jonsowman/GutterNode/enclosure/gutside.stl

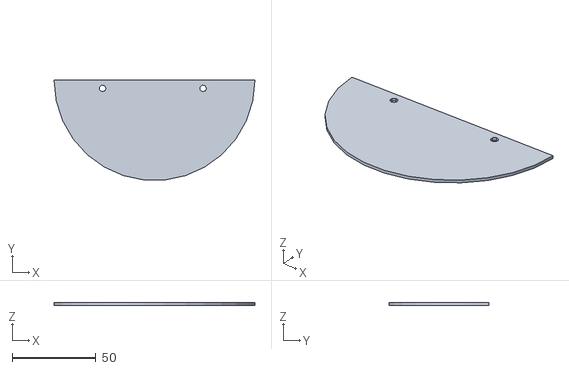
[picture p1: CAD file, 2015-03-28]
enclosure/gutside.stl
120.0 x 59.7 x 1.50
