jonsowman/GutterNode/enclosure/gnode21.stl

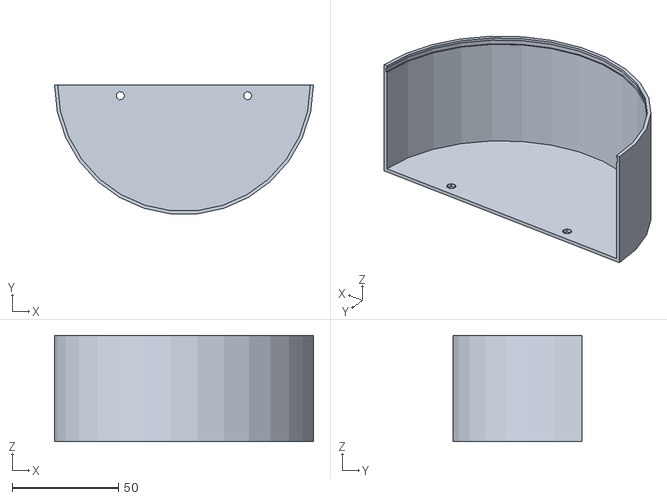
[picture p2: CAD file, 2015-03-26]
enclosure/gnode21.stl
122.0 x 60.7 x 50.0
