jonsowman/GutterNode/enclosure/guttop.stl

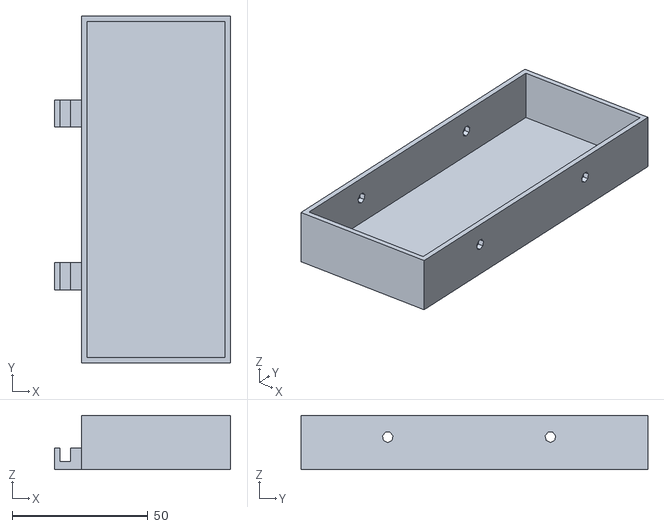
[picture p3: CAD file, 2015-03-25]
enclosure/guttop.stl
65.0 x 128.0 x 20.0
