jonsowman/GutterNode/hardware/cn3083-breakout/breakout.brd

## EAGLE design hardware/cn3083-breakout/breakout.brd (2015-04-07)

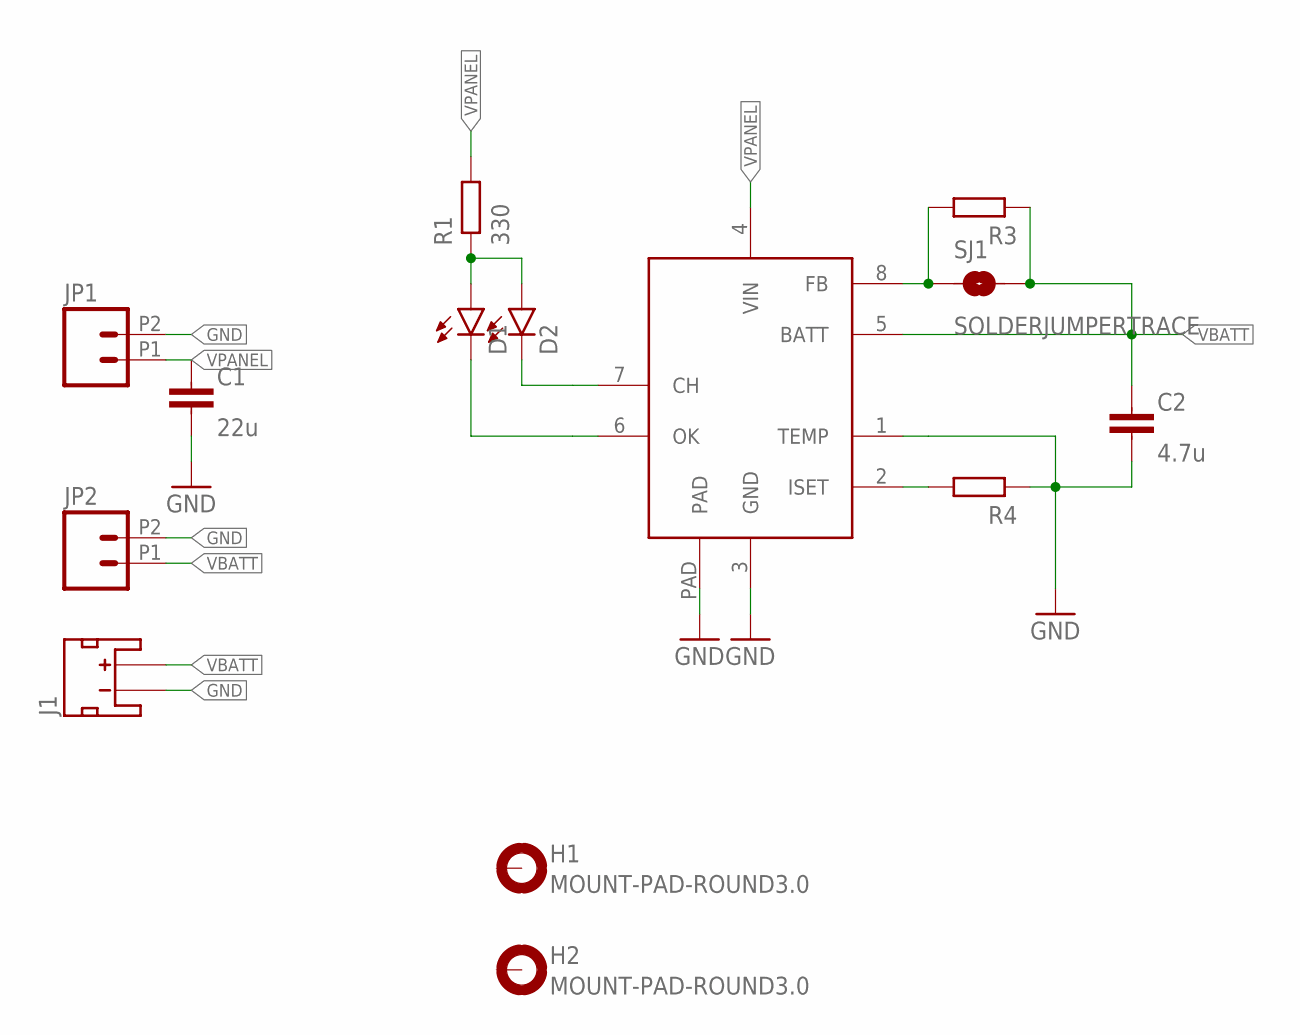
[picture p4: schematic breakout.sch]

Parts:
C1: 22u; C0603-N
C2: 4.7u; C0603-N
D1, D2: LED0603; LED-0603
H1, H2: MOUNT-PAD-ROUND3.0; 3,0-PAD
J1: JST_2MM_MALE_TH; JST-2-TH
JP1, JP2: M022.54MM_SCREWTERM; 1X02_2.54_SCREWTERM
R1: 330; R0603-N
R3, R4: RESISTOR0603-N; R0603-N
SJ1: SOLDERJUMPERTRACE; SJ_2S-TRACE
U1: CN3083; SO8-PAD

Connections:
GND: C1.2, C2.2, J1.2 (-), JP1.P2 (2), JP2.P2 (2), R4.1, U1.1 (TEMP), U1.3 (GND), U1.PAD
unnamed: D1.A, D2.A, R1.1
unnamed: R4.2, U1.2 (ISET)
unnamed: D2.C, U1.7 (CH)
unnamed: D1.C, U1.6 (OK)
unnamed: R3.2, SJ1.1, U1.8 (FB)
VBATT: C2.1, J1.1 (+), JP2.P1 (1), R3.1, SJ1.2, U1.5 (BATT)
VPANEL: C1.1, JP1.P1 (1), R1.2, U1.4 (VIN)

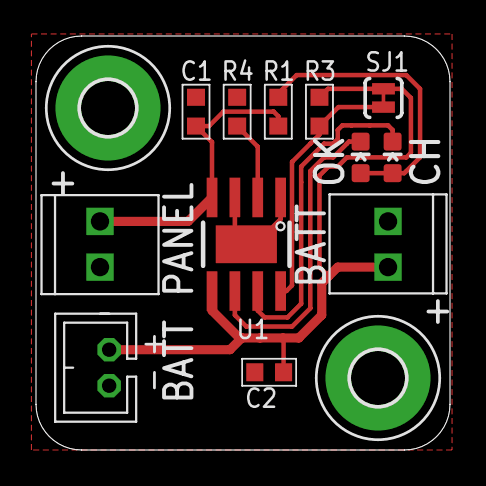
[picture p5: board breakout.brd from above]

Board: 2 copper layers, 23.0 x 23.0 mm, 14 parts (0 on the bottom side), 8 nets.
