jonsowman/GutterNode/hardware/gnode/gnode.brd

## EAGLE design hardware/gnode/gnode.brd (2015-04-05)

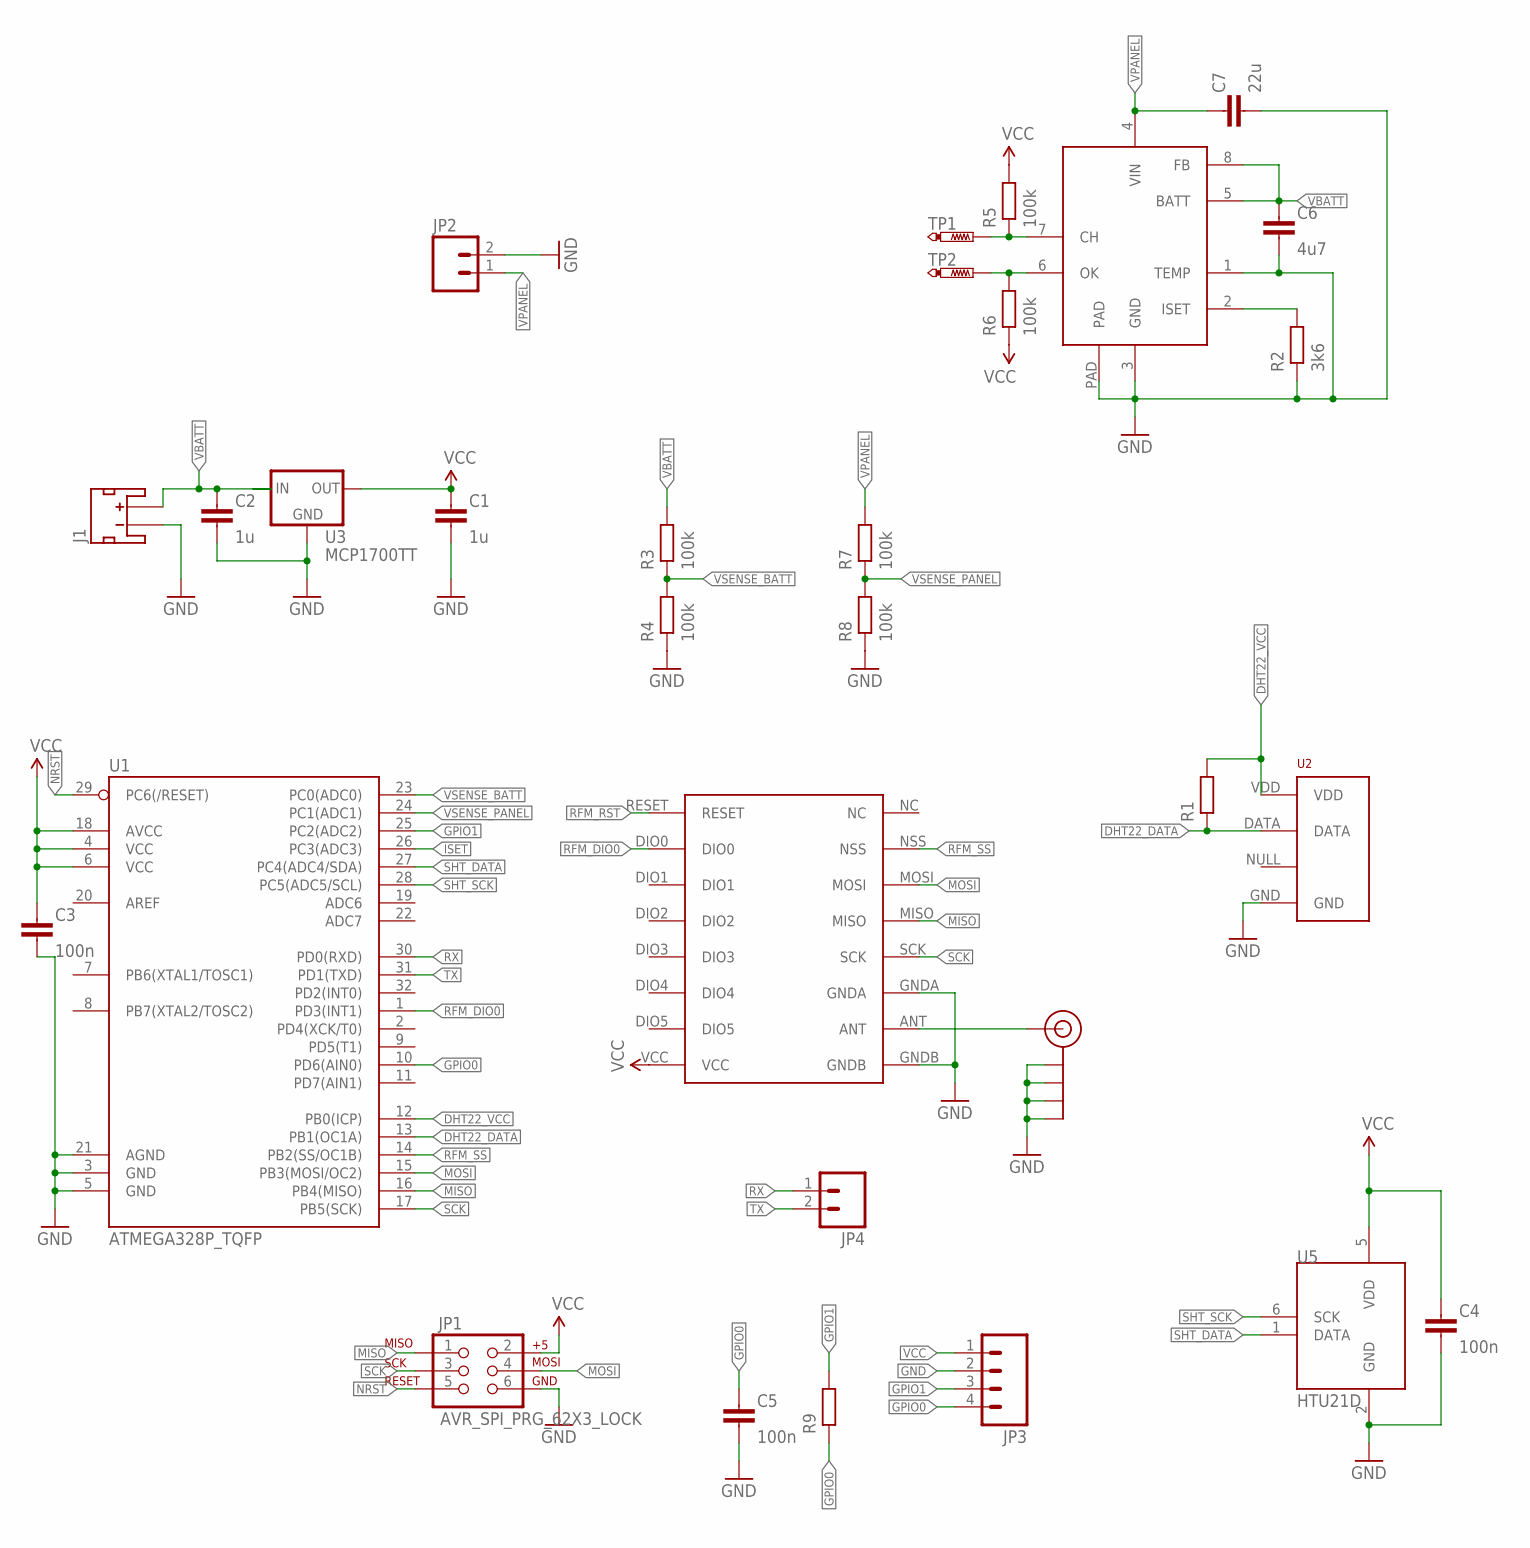
[picture p6: schematic gnode.sch]

Parts:
C1, C2: 1u; C0603-N
C3, C4, C5: 100n; C0603-N
C6: 4u7; C0603-N
C7: 22u; C0603-N
J1: JST_2MM_MALE_TH; JST-2-TH
J$1: SMA_EDGE; SMA-EDGE
JP1: AVR_SPI_PRG_62X3_LOCK; 2X3_LOCK
JP2, JP4: M02PTH; 1X02
JP3: M04PTH; 1X04
R1, R9: RESISTOR0603-N; R0603-N
R2: 3k6; R0603-N
R3, R4, R5, R6, R7, R8: 100k; R0603-N
TP1, TP2: PTR1B1,27; B1,27
U1: ATMEGA328P_TQFP; TQFP32-08
U2: RHT03_DHT-22_AM2302; RHT03_DHT-22
U3: MCP1700TT; SOT23
U4: CN3083; SO8-PAD
U5: HTU21D; DFN6-L
U$1: RFM69HW; RFM

Connections:
DHT22_DATA: R1.1, U1.13 (PB1(OC1A)), U2.DATA
DHT22_VCC: R1.2, U1.12 (PB0(ICP)), U2.VDD
GND: C1.2, C2.2, C3.2, C4.2, C5.2, C6.2, C7.2, J1.2 (-), J$1.GND@0 (GND), J$1.GND@1 (GND), J$1.GND@2 (GND), J$1.GND@3 (GND), JP1.6, JP2.2, JP3.2, R2.1, R4.1, R8.1, U1.3 (GND), U1.5 (GND), U1.21 (AGND), U2.GND, U3.1 (GND), U4.1 (TEMP), U4.3 (GND), U4.PAD, U5.2 (GND), U$1.GNDA, U$1.GNDB
GPIO0: C5.1, JP3.4, R9.1, U1.10 (PD6(AIN0))
GPIO1: JP3.3, R9.2, U1.25 (PC2(ADC2))
ISET: R2.2, U1.26 (PC3(ADC3)), U4.2 (ISET)
MISO: JP1.1, U1.16 (PB4(MISO)), U$1.MISO
MOSI: JP1.4, U1.15 (PB3(MOSI/OC2)), U$1.MOSI
unnamed: J$1.SIG (SIGNAL), U$1.ANT
unnamed: R5.1, TP1.TP, U4.7 (CH)
unnamed: R6.2, TP2.TP, U4.6 (OK)
NRST: JP1.5, U1.29 (PC6(/RESET))
RFM_DIO0: U1.1 (PD3(INT1)), U$1.DIO0
RFM_RST: U$1.RESET
RFM_SS: U1.14 (PB2(SS/OC1B)), U$1.NSS
RX: JP4.1, U1.30 (PD0(RXD))
SCK: JP1.3, U1.17 (PB5(SCK)), U$1.SCK
SHT_DATA: U1.27 (PC4(ADC4/SDA)), U5.1 (DATA)
SHT_SCK: U1.28 (PC5(ADC5/SCL)), U5.6 (SCK)
TX: JP4.2, U1.31 (PD1(TXD))
VBATT: C2.1, C6.1, J1.1 (+), R3.2, U3.3 (IN), U4.5 (BATT), U4.8 (FB)
VCC: C1.1, C3.1, C4.1, JP1.2, JP3.1, R5.2, R6.1, U1.4 (VCC), U1.6 (VCC), U1.18 (AVCC), U3.2 (OUT), U5.5 (VDD), U$1.VCC
VPANEL: C7.1, JP2.1, R7.2, U4.4 (VIN)
VSENSE_BATT: R3.1, R4.2, U1.23 (PC0(ADC0))
VSENSE_PANEL: R7.1, R8.2, U1.24 (PC1(ADC1))

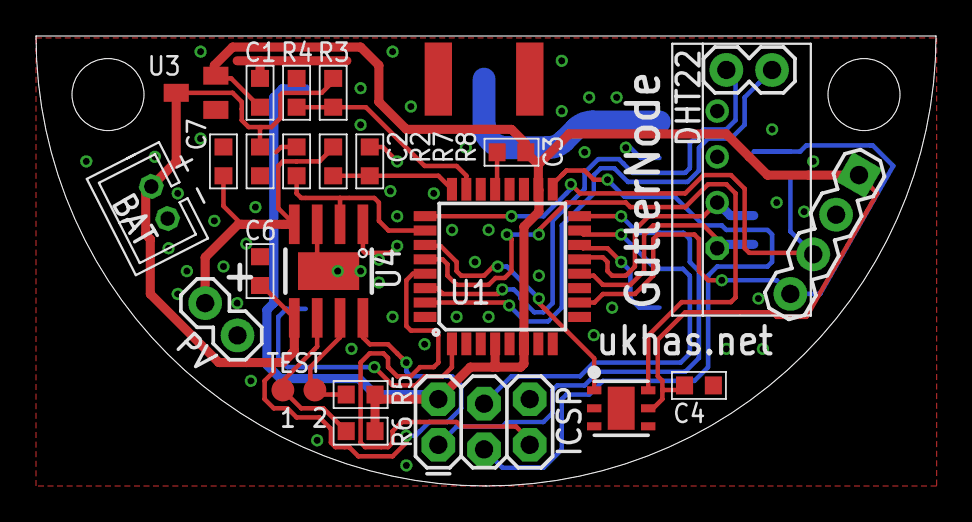
[picture p7: board gnode.brd from above]

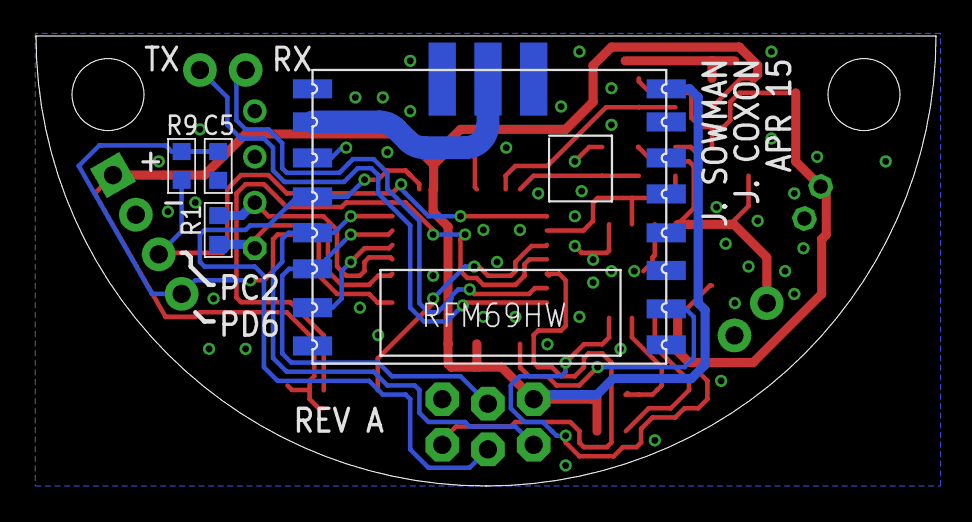
[picture p8: board gnode.brd from below]

Board: 2 copper layers, 50.0 x 25.0 mm, 30 parts (5 on the bottom side), 24 nets.
