jonsowman/GutterNode/(commit log)

2015-03-25 added scad files for parts
    [gnode2.scad, gnode3.scad, guttop.scad]
2015-03-25 increased size of gutter top as was too tight (and we want a bit of overhang), also increased size of screw hole radius as too small
    [guttop.scad]
2015-03-25 now all the screw holes are the same size
    [guttop.scad]
2015-03-25 added clips to attach the gutternode to the gutter
    [guttop.scad]
2015-03-25 added stl of gutter top
    [guttop.stl]
2015-03-25 increased width of clip size and also gap between box and clips as ends appear to have slight curve
    [guttop.scad]
2015-03-25 moved screw holes and clips closer into centre to avoid gutter edges
    [guttop.scad]
2015-03-25 rebuilt stl
    [guttop.stl]
2015-03-25 updated screw holes to same as gutter top
    [gnode2.scad]
2015-03-26 moved screw holes to hopefully fit, also made the wall thickness thinner to save of material
    [gnode2.scad]
2015-03-26 added side panel and lip
    [gnode2.scad, gnode3.scad]
2015-03-26 improved lip,
    [gnode2.scad]
2015-03-26 added gnode stl
    [gnode21.stl]
2015-03-27 fixed the position of the screw holes by moving them 1mm (after finding a small difference with the last test print), also added modules for 'mainbox' and 'sidepanel' to allow easy selection of the c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
    [gnode2.scad]
2015-03-28 added stl of gutside
    [gutside.stl]
2015-03-30 moved files to enclosure/
    [gnode2.scad, gnode21.stl, gnode3.scad, gutside.stl, guttop.scad, guttop.stl]
2015-03-30 added first run of pcb stuff
    [gnode.brd, gnode.sch]
2015-03-30 reduced to r25mm, added htu21d and icsp header
    [gnode.brd, gnode.sch]
2015-03-30 switched to mcp1700
    [gnode.brd, gnode.sch]
2015-03-30 added cn3083 solar charger
    [gnode.brd, gnode.sch]
2015-03-30 sense panel and battery voltages
    [gnode.brd, gnode.sch]
2015-03-30 centred the sma connector, placed resistors for sense potdivs
    [gnode.brd]
2015-04-03 routed gpio for adc/pwm
    [gnode.brd, gnode.sch]
2015-04-03 tidying. ready to go
    [gnode.brd, gnode.sch]
2015-04-04 added RC for rain sensing. part numbers on silk
    [gnode.brd, gnode.sch]
2015-04-04 ISET connected to ADC pin so we can calculate the charge current
    [gnode.brd, gnode.sch]
2015-04-04 increased text size
    [gnode.brd]
2015-04-04 OCD improvements
    [gnode.brd]
2015-04-04 uart broken out
    [gnode.brd, gnode.sch]
2015-04-04 bottom pad and heatsinking for cn3083
    [gnode.brd]
2015-04-05 cn3083 breakout
    [breakout.brd, breakout.sch]
2015-04-05 improved ground return
    [breakout.brd]
2015-04-05 added caps for cn3083, oops
    [breakout.brd, breakout.sch, gnode.brd, gnode.sch]
2015-04-05 added silk for name and revision
    [gnode.brd]
2015-04-07 final bits before manufacture
    [breakout.brd]
